elecnclab/02-orologio-datario-ds3231/media/orologio-datario-due-modelli-v01.jpg

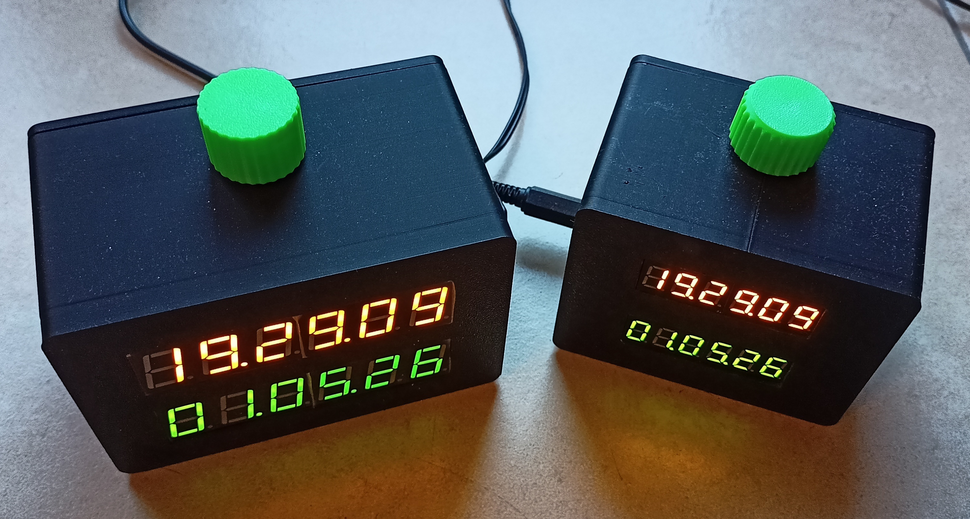
media/orologio-datario-due-modelli-v01.jpg
