elecnclab/02-orologio-datario-ds3231/media/orologio-datario-nuova-elettronica-251-2026-v01.png

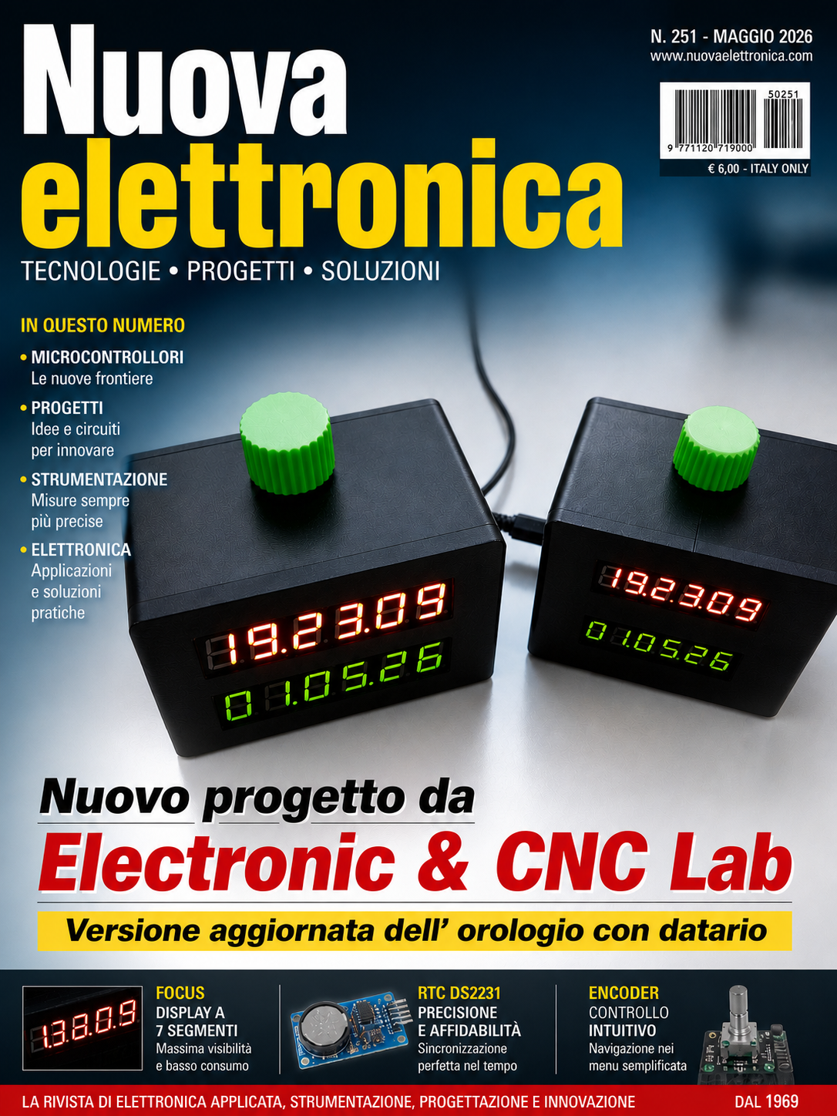
media/orologio-datario-nuova-elettronica-251-2026-v01.png
