elecnclab/02-orologio-datario-ds3231/hardware/stl/orologio-manopola-v01.stl

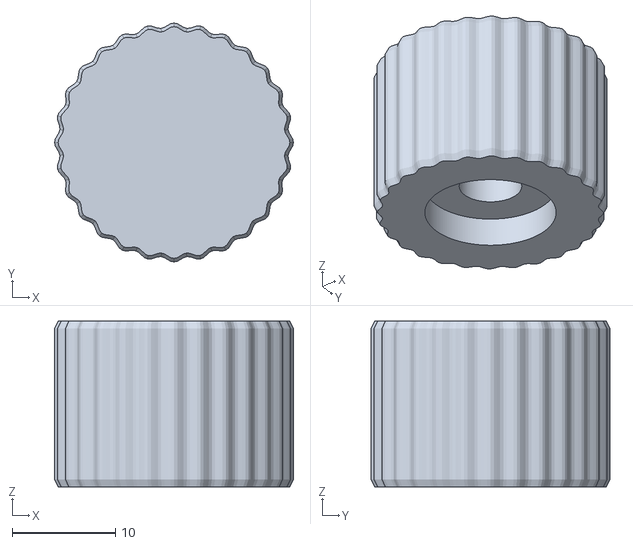
[picture p3: CAD file, 2026-04-26]
hardware/stl/orologio-manopola-v01.stl
23.1 x 23.1 x 16.0
