elecnclab/02-orologio-datario-ds3231/hardware/stl/orologio-cornice-v01.stl

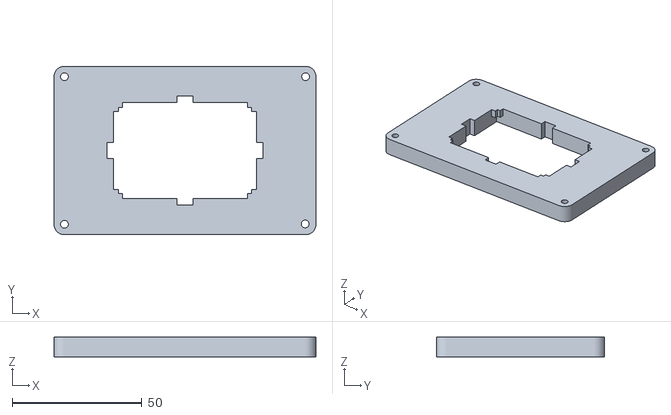
[picture p4: CAD file, 2026-04-25]
hardware/stl/orologio-cornice-v01.stl
100.8 x 64.8 x 7.60
