elecnclab/02-orologio-datario-ds3231/hardware/stl/orologio-coperchio-v01.stl

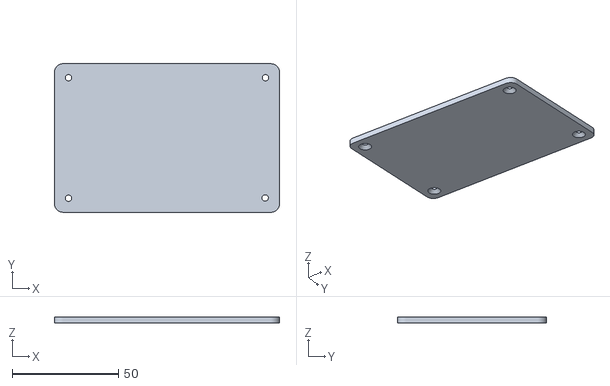
[picture p5: CAD file, 2026-04-25]
hardware/stl/orologio-coperchio-v01.stl
106.0 x 70.0 x 3.00
