elecnclab/02-orologio-datario-ds3231/hardware/stl/orologio-scatola-v01.stl

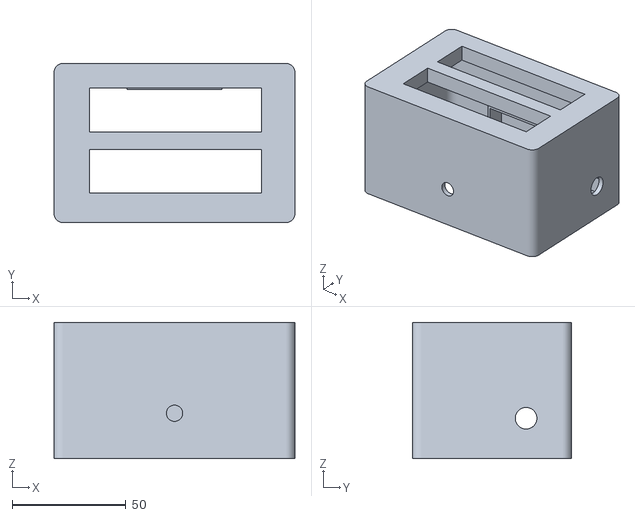
[picture p6: CAD file, 2026-04-25]
hardware/stl/orologio-scatola-v01.stl
106.0 x 70.0 x 59.9
