elecnclab/02-orologio-datario-ds3231/hardware/schemi/orologio-datario-schema-elettrico-v01.pdf

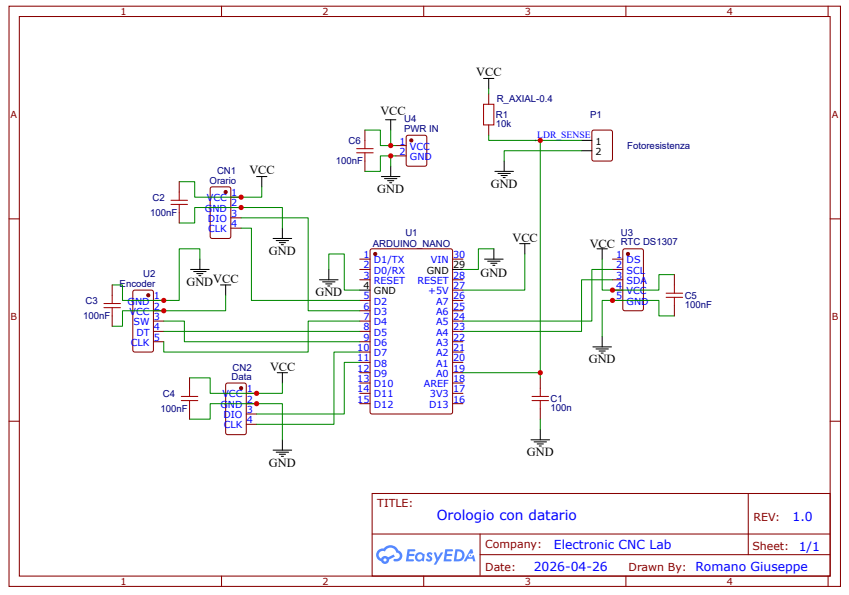
[picture p7: page 1]

Company: Electronic CNC Lab

Drawn By: Romano Giuseppe
