elecnclab/02-orologio-datario-ds3231/(commit log)

2026-04-25 chore: inizializza struttura progetto orologio datario ds3231
    [orologio-coperchio-v01.stl, orologio-cornice-v01.stl, orologio-scatola-v01.stl]
2026-04-26 feat(hardware): aggiunge STL manopola encoder v01
    [orologio-manopola-v01.stl]
2026-04-26 docs(bom): aggiunge e popola elenco componenti
    [bom.csv]
2026-04-26 docs(bom): aggiunge link GitHub per STL coperchio cornice scatola
    [bom.csv]
2026-04-26 docs(bom): aggiunge voce schema elettrico PDF
    [bom.csv]
2026-05-01 feat(firmware): nuova logica set orario/data e fix step encoder
    [orologio-datario-ds3231.ino]
2026-05-01 media: aggiunge foto dei due modelli di orologio
2026-05-03 chore(release): 0.1.4 luminosita encoder e fix transizione display
    [orologio-datario-ds3231.ino]
